tseary/Console_FX/README.md

# Console_FX
Controller for steam power plant control console "light show".
