tseary/Console_FX/PCB_Console_Lighting_v2/Console_Lighting_v2.kicad_pcb

## KiCad design PCB_Console_Lighting_v2/Console_Lighting_v2.kicad_pcb (2017-08-30)

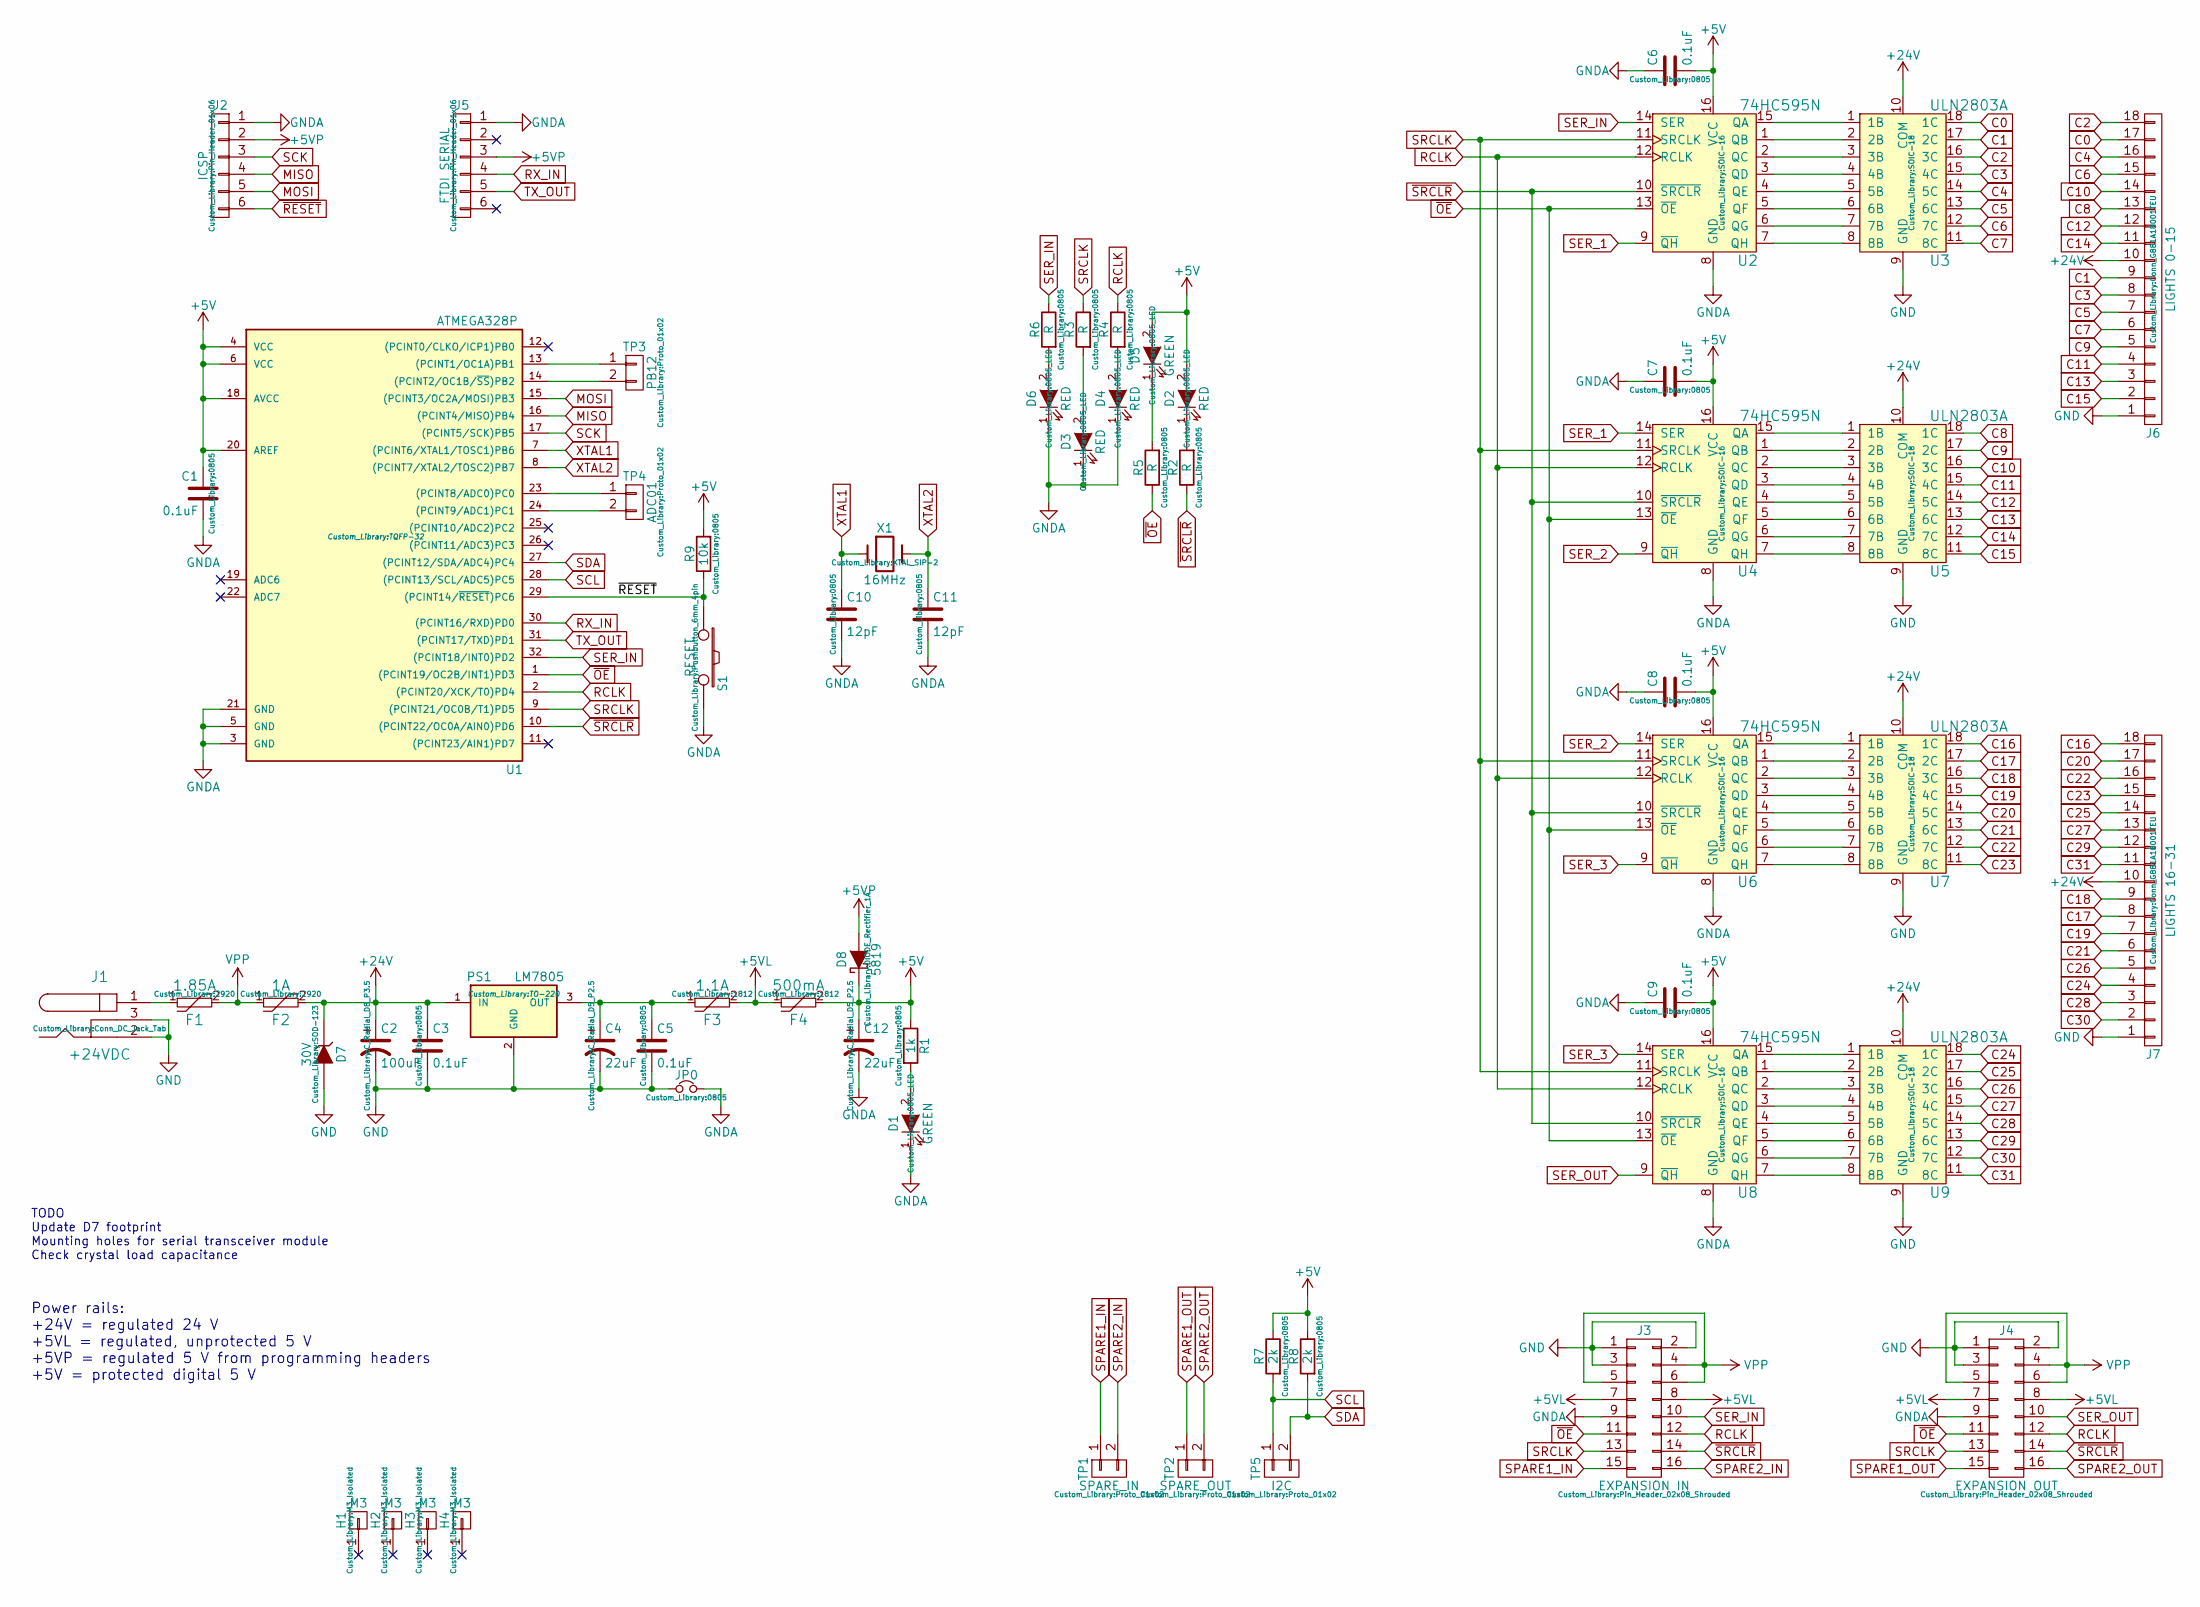
[picture p1: schematic Console_Lighting_v2.sch]

Parts:
C1, C3, C5, C6, C7, C8, C9: 0.1uF; 0805
C2: 100uF; C_Radial_D8_P3.5
C4, C12: 22uF; C_Radial_D5_P2.5
C10, C11: 12pF; 0805
D1, D5: GREEN; 0805_LED
D2, D3, D4, D6: RED; 0805_LED
D7: 30V; SOD-123
D8: 5819; DIODE_Rectifier_1A
F1: 1.85A; 2920
F2: 1A; 2920
F3: 1.1A; 1812
F4: 500mA; 1812
H1, H2, H3, H4: M3; M3_Isolated
J1: +24VDC; Conn_DC_Jack_Tab
J2: ICSP; Pin_Header_01x06
J3: EXPANSION IN; Pin_Header_02x08_Shrouded
J4: EXPANSION OUT; Pin_Header_02x08_Shrouded
J5: FTDI SERIAL; Pin_Header_01x06
J6: LIGHTS 0-15; Conn_G881A18001TEU
J7: LIGHTS 16-31; Conn_G881A18001TEU
JP0: Jumper_NC_Small; 0805
PS1: LM7805; TO-220
R1: 1k; 0805
R2, R3, R4, R5, R6: R; 0805
R7, R8: 2k; 0805
R9: 10k; 0805
S1: RESET; Pushbutton_6mm_4pin
TP1: SPARE_IN; Proto_01x02
TP2: SPARE_OUT; Proto_01x02
TP3: PB12; Proto_01x02
TP4: ADC01; Proto_01x02
TP5: I2C; Proto_01x02
U1: ATMEGA328P; TQFP-32
U2, U4, U6, U8: 74HC595N; SOIC-16
U3, U5, U7, U9: ULN2803A; SOIC-18
X1: 16MHz; XTAL_SIP-2

Connections:
+5V: C1.1, C6.2, C7.2, C8.2, C9.2, C12.1, D2.2 (A), D5.2 (A), D8.1 (K), F4.2, R1.1, R7.1, R8.1, R9.2, U1.4 (VCC), U1.6 (VCC), U1.18 (AVCC), U1.20 (AREF), U2.16 (VCC), U4.16 (VCC), U6.16 (VCC), U8.16 (VCC)
+5VL: F3.2, F4.1, J3.7, J3.8, J4.7, J4.8
+5VP: D8.2 (A), J2.2, J5.3
+24V: C2.1, C3.1, D7.1 (K), F2.2, J6.10, J7.10, PS1.1 (IN), U3.10 (COM), U5.10 (COM), U7.10 (COM), U9.10 (COM)
C0: J6.17, U3.18 (1C)
C1: J6.9, U3.17 (2C)
C2: J6.18, U3.16 (3C)
C3: J6.8, U3.15 (4C)
C4: J6.16, U3.14 (5C)
C5: J6.7, U3.13 (6C)
C6: J6.15, U3.12 (7C)
C7: J6.6, U3.11 (8C)
C8: J6.13, U5.18 (1C)
C9: J6.5, U5.17 (2C)
C10: J6.14, U5.16 (3C)
C11: J6.4, U5.15 (4C)
C12: J6.12, U5.14 (5C)
C13: J6.3, U5.13 (6C)
C14: J6.11, U5.12 (7C)
C15: J6.2, U5.11 (8C)
C16: J7.18, U7.18 (1C)
C17: J7.8, U7.17 (2C)
C18: J7.9, U7.16 (3C)
C19: J7.7, U7.15 (4C)
C20: J7.17, U7.14 (5C)
C21: J7.6, U7.13 (6C)
C22: J7.16, U7.12 (7C)
C23: J7.15, U7.11 (8C)
C24: J7.4, U9.18 (1C)
C25: J7.14, U9.17 (2C)
C26: J7.5, U9.16 (3C)
C27: J7.13, U9.15 (4C)
C28: J7.3, U9.14 (5C)
C29: J7.12, U9.13 (6C)
C30: J7.2, U9.12 (7C)
C31: J7.11, U9.11 (8C)
GND: C2.2, C3.2, C4.2, C5.2, D7.2 (A), J1.2, J1.3, J3.1, J3.2, J3.3, J4.1, J4.2, J4.3, J6.1, J7.1, JP0.1, PS1.2 (GND), U3.9 (GND), U5.9 (GND), U7.9 (GND), U9.9 (GND)
GNDA: C1.2, C6.1, C7.1, C8.1, C9.1, C10.2, C11.2, C12.2, D1.1 (K), D3.1 (K), D4.1 (K), D6.1 (K), J2.1, J3.9, J4.9, J5.1, JP0.2, S1.2, U1.3 (GND), U1.5 (GND), U1.21 (GND), U2.8 (GND), U4.8 (GND), U6.8 (GND), U8.8 (GND)
MISO: J2.4, U1.16 ((PCINT4/MISO)PB4)
MOSI: J2.5, U1.15 ((PCINT3/OC2A/MOSI)PB3)
unnamed: C4.1, C5.1, F3.1, PS1.3 (OUT)
unnamed: D1.2 (A), R1.2
unnamed: D2.1 (K), R2.2
unnamed: D3.2 (A), R3.2
unnamed: D4.2 (A), R4.2
unnamed: D5.1 (K), R5.2
unnamed: D6.2 (A), R6.2
unnamed: F1.1, J1.1
unnamed: TP3.1, U1.13 ((PCINT1/OC1A)PB1)
unnamed: TP3.2, U1.14 ((PCINT2/OC1B/~SS~)PB2)
unnamed: TP4.1, U1.23 ((PCINT8/ADC0)PC0)
unnamed: TP4.2, U1.24 ((PCINT9/ADC1)PC1)
unnamed: U2.1 (QB), U3.2 (2B)
unnamed: U2.2 (QC), U3.3 (3B)
unnamed: U2.3 (QD), U3.4 (4B)
unnamed: U2.4 (QE), U3.5 (5B)
unnamed: U2.5 (QF), U3.6 (6B)
unnamed: U2.6 (QG), U3.7 (7B)
unnamed: U2.7 (QH), U3.8 (8B)
unnamed: U2.15 (QA), U3.1 (1B)
unnamed: U4.1 (QB), U5.2 (2B)
unnamed: U4.2 (QC), U5.3 (3B)
unnamed: U4.3 (QD), U5.4 (4B)
unnamed: U4.4 (QE), U5.5 (5B)
unnamed: U4.5 (QF), U5.6 (6B)
unnamed: U4.6 (QG), U5.7 (7B)
unnamed: U4.7 (QH), U5.8 (8B)
unnamed: U4.15 (QA), U5.1 (1B)
unnamed: U6.1 (QB), U7.2 (2B)
unnamed: U6.2 (QC), U7.3 (3B)
unnamed: U6.3 (QD), U7.4 (4B)
unnamed: U6.4 (QE), U7.5 (5B)
unnamed: U6.5 (QF), U7.6 (6B)
unnamed: U6.6 (QG), U7.7 (7B)
unnamed: U6.7 (QH), U7.8 (8B)
unnamed: U6.15 (QA), U7.1 (1B)
unnamed: U8.1 (QB), U9.2 (2B)
unnamed: U8.2 (QC), U9.3 (3B)
unnamed: U8.3 (QD), U9.4 (4B)
unnamed: U8.4 (QE), U9.5 (5B)
unnamed: U8.5 (QF), U9.6 (6B)
unnamed: U8.6 (QG), U9.7 (7B)
unnamed: U8.7 (QH), U9.8 (8B)
unnamed: U8.15 (QA), U9.1 (1B)
RCLK: J3.12, J4.12, R4.1, U1.2 ((PCINT20/XCK/T0)PD4), U2.12 (RCLK), U4.12 (RCLK), U6.12 (RCLK), U8.12 (RCLK)
RX_IN: J5.4, U1.30 ((PCINT16/RXD)PD0)
SCK: J2.3, U1.17 ((PCINT5/SCK)PB5)
SCL: R7.2, TP5.1, U1.28 ((PCINT13/SCL/ADC5)PC5)
SDA: R8.2, TP5.2, U1.27 ((PCINT12/SDA/ADC4)PC4)
SER_1: U2.9 (~QH), U4.14 (SER)
SER_2: U4.9 (~QH), U6.14 (SER)
SER_3: U6.9 (~QH), U8.14 (SER)
SER_IN: J3.10, R6.1, U1.32 ((PCINT18/INT0)PD2), U2.14 (SER)
SER_OUT: J4.10, U8.9 (~QH)
SPARE1_IN: J3.15, TP1.1
SPARE1_OUT: J4.15, TP2.1
SPARE2_IN: J3.16, TP1.2
SPARE2_OUT: J4.16, TP2.2
SRCLK: J3.13, J4.13, R3.1, U1.9 ((PCINT21/OC0B/T1)PD5), U2.11 (SRCLK), U4.11 (SRCLK), U6.11 (SRCLK), U8.11 (SRCLK)
TX_OUT: J5.5, U1.31 ((PCINT17/TXD)PD1)
VPP: F1.2, F2.1, J3.4, J3.5, J3.6, J4.4, J4.5, J4.6
XTAL1: C10.1, U1.7 ((PCINT6/XTAL1/TOSC1)PB6), X1.1
XTAL2: C11.1, U1.8 ((PCINT7/XTAL2/TOSC2)PB7), X1.2
~OE: J3.11, J4.11, R5.1, U1.1 ((PCINT19/OC2B/INT1)PD3), U2.13 (~OE), U4.13 (~OE), U6.13 (~OE), U8.13 (~OE)
~RESET: J2.6, R9.1, S1.1, U1.29 ((PCINT14/~RESET~)PC6)
~SRCLR: J3.14, J4.14, R2.1, U1.10 ((PCINT22/OC0A/AIN0)PD6), U2.10 (~SRCLR), U4.10 (~SRCLR), U6.10 (~SRCLR), U8.10 (~SRCLR)

Notes on the sheet:
TODO Update D7 footprint Mounting holes for serial transceiver module Check crystal load capacitance
Power rails: +24V = regulated 24 V +5VL = regulated, unprotected 5 V +5VP = regulated 5 V from programming headers +5V = protected digital 5 V

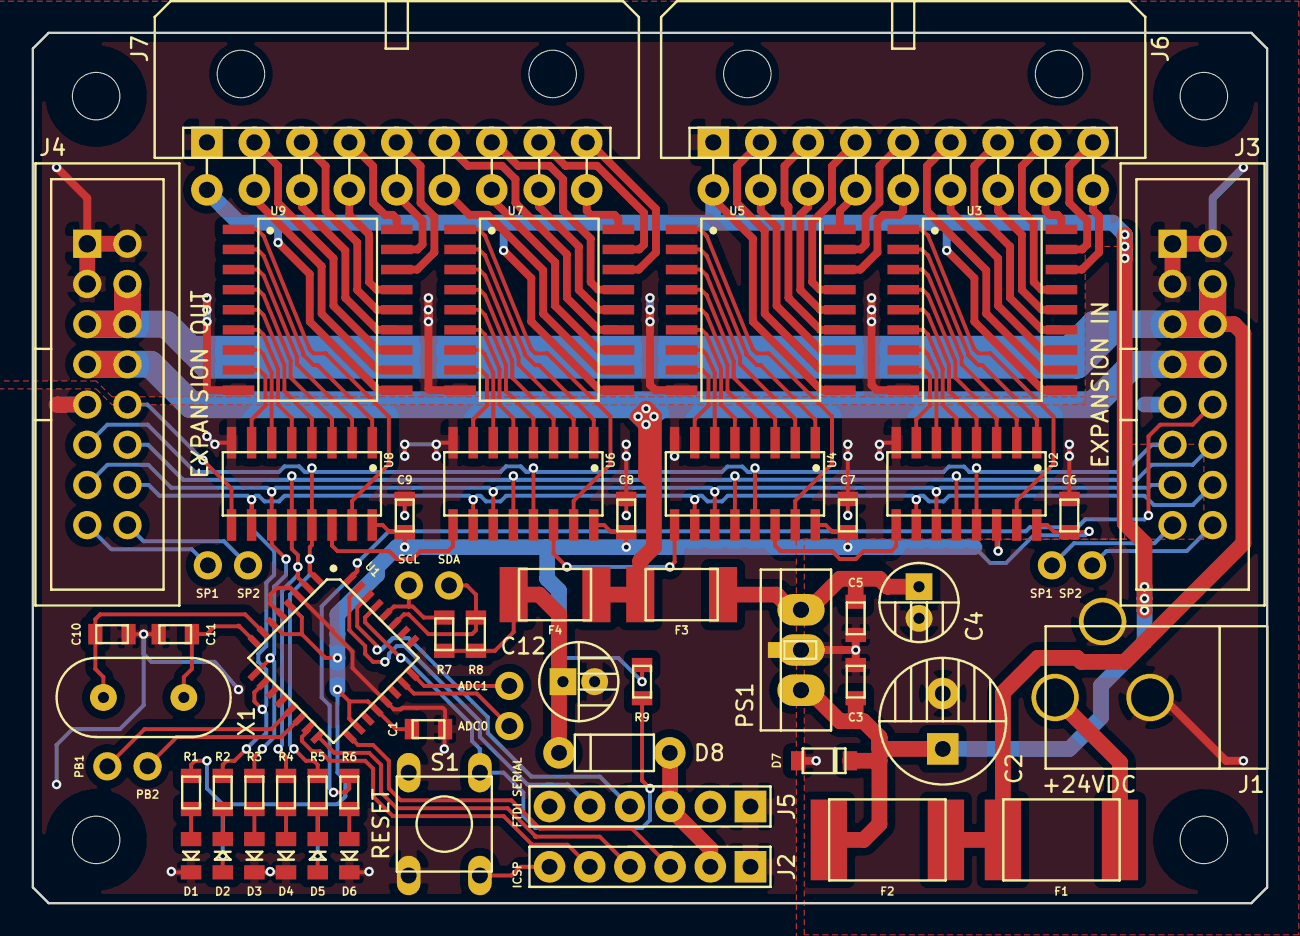
[picture p2: board Console_Lighting_v2.kicad_pcb from above]

Board: 2 copper layers, 78.0 x 55.0 mm, 62 parts (0 on the bottom side), 106 nets.
